Muzoka/Robotic-comp/sim/runs/map1.gif

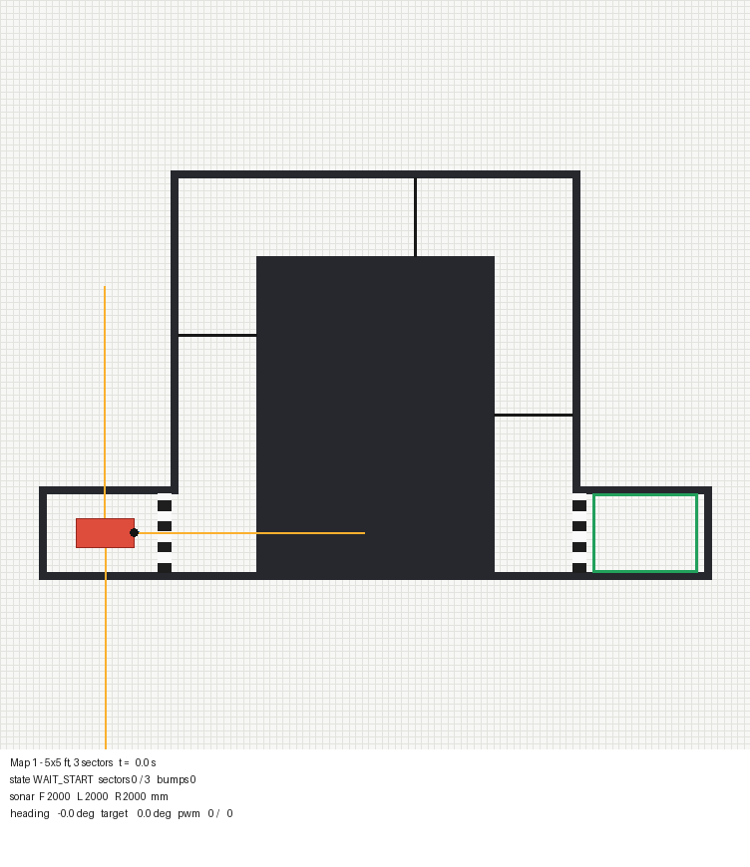
sim/runs/map1.gif
