Muzoka/Robotic-comp/sim/runs/map2.gif

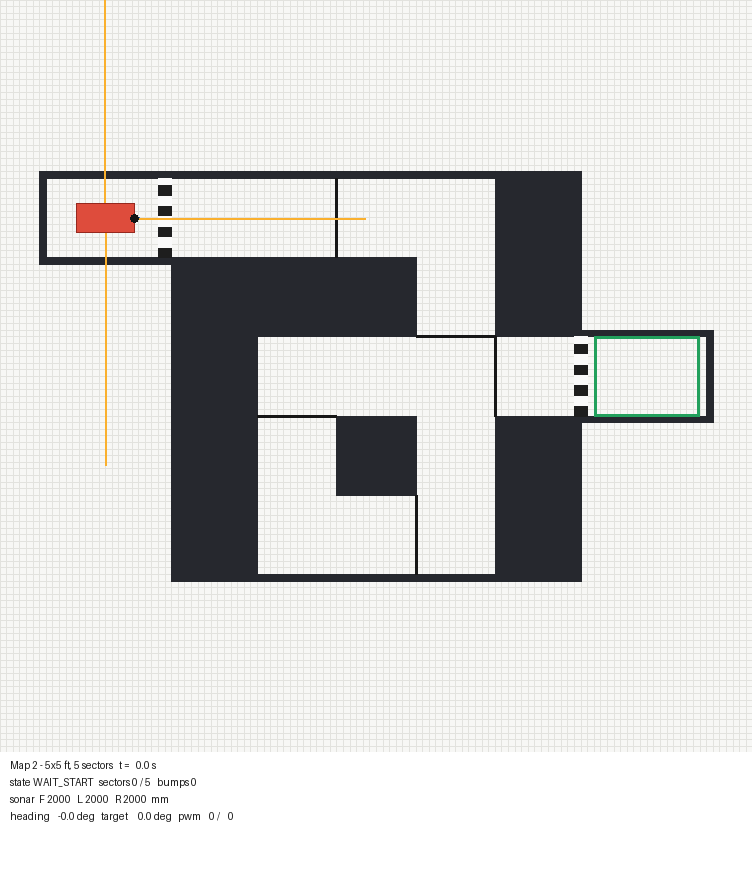
sim/runs/map2.gif
