Muzoka/Robotic-comp/sim/runs/map3.gif

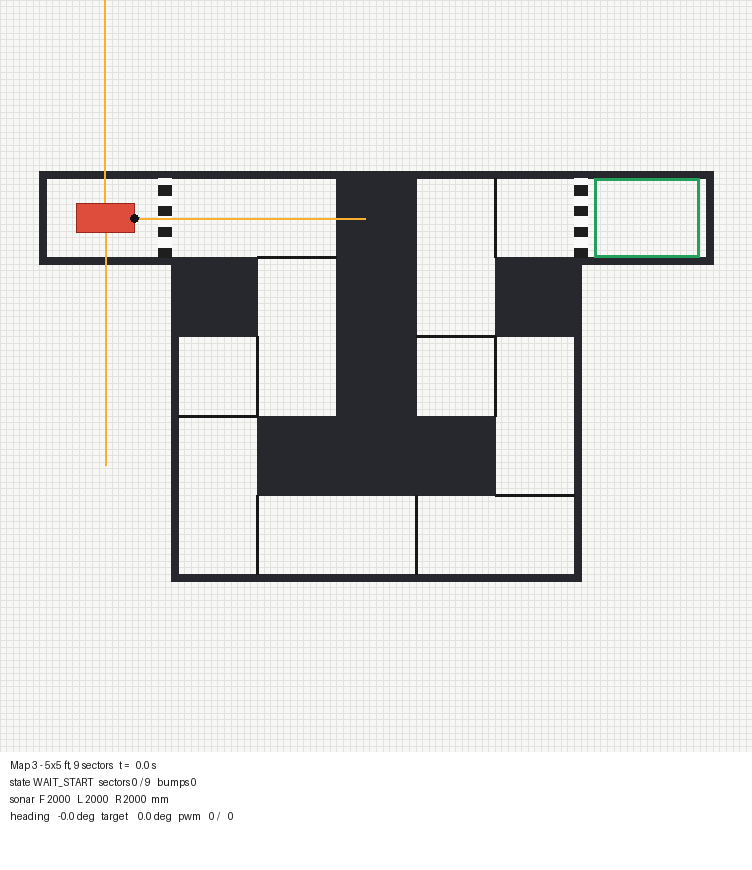
sim/runs/map3.gif
