Muzoka/Robotic-comp/docs/build_guide.html

Language / اللغة EN + ع English عربي

Robotics Navigation Challenge · Arduino Uno

# MazeRunner Build Guide دليل بناء روبوت المتاهة

Everything from the shop counter to the start line: what to buy, how to wire it, what to test at each stage, and what to do on the day. Written for one specific robot that has been simulated to completion — but the method transfers to any two-wheeled maze robot on an Uno.

كل شيء من المحل إلى خط البداية: ماذا تشتري، كيف توصّل الأسلاك، ما الذي تختبره في كل مرحلة، وماذا تفعل يوم المسابقة. مكتوب لروبوت واحد محدد تم اختباره بالمحاكاة حتى نجح في كل الخرائط — لكن الطريقة نفسها تنفع لأي روبوت متاهة بعجلتين يعمل على Arduino Uno.

Maps completed الخرائط المكتملة

3 / 3

Sector points نقاط القطاعات

17 / 17

Simulated runs جولات المحاكاة

96 all passed

Slowest map أبطأ خريطة

48 s of 180

Wall contact الاصطدام بالجدران

0

PHASE 00

## Before you spend anything قبل أن تصرف ريالاً واحداً

~30 minNo parts neededلا تحتاج أي قطعة

One measurement decides whether this robot can work at all, and it is not about code. A two-wheeled robot pivoting on the spot sweeps a circle as wide as its body diagonal. If that circle does not fit between the walls, the robot cannot turn around — no amount of tuning fixes it.

هناك قياس واحد يحدد إن كان هذا الروبوت سينجح أصلاً، ولا علاقة له بالبرمجة. الروبوت ذو العجلتين حين يدور حول نفسه يرسم دائرة قطرها بقدر قطر جسمه (من زاوية إلى الزاوية المقابلة). إذا كانت هذه الدائرة أوسع من المسافة بين الجدارين، فالروبوت لا يستطيع الدوران — ولن يصلحه أي ضبط في الكود.

The competition passage is one foot: 304.8 mm.

عرض الممر في المسابقة قدم واحدة: 304.8 مم.

Robot size مقاس الروبوت | Body diagonal قطر الجسم | Clearance الهامش | Verdict النتيجة
250 × 150 mm | 292 mm | 6 mm | Jams in cornersينحشر في الزوايا
220 × 115 mm | 248 mm | 28 mm | Target — build to thisالهدف — ابنِ على هذا المقاس
200 × 110 mm | 228 mm | 38 mm | Fits, but twitchy — short wheelbaseيمر، لكنه غير مستقر بسبب قصر المسافة بين العجلتين

220 × 115 mm is a measured optimum, not a guess. Narrower is not automatically better: a narrower body means a shorter wheelbase, which makes the robot more sensitive to motor mismatch. In simulation, 110 mm wide completed 83% of runs and 115 mm completed 97%.

مقاس 220 × 115 مم نتيجة قياس، وليس تخميناً. الأضيق ليس أفضل تلقائياً: الجسم الأضيق يعني مسافة أقصر بين العجلتين، وهذا يجعل الروبوت أكثر حساسية لاختلاف قوة المحركين. في المحاكاة، العرض 110 مم أكمل 83% من الجولات، بينما 115 مم أكمل 97%.

Measure this today · قِس هذا اليوم

Put a ruler across your chassis as it stands, nose to tail and tyre-outside to tyre-outside. Most kit builds come out around 250 × 150 mm, and almost all of the excess is in the front ultrasonic bracket hanging off the nose. You need to find about 3 cm of length. Knowing that now changes what you buy.

ضع المسطرة على الهيكل كما هو الآن: من المقدمة إلى المؤخرة، ومن الحافة الخارجية للإطار الأيسر إلى الحافة الخارجية للإطار الأيمن. أغلب الروبوتات المبنية من الكِت تكون حوالي 250 × 150 مم، والزيادة كلها تقريباً في حامل الحساس الأمامي البارز من المقدمة. تحتاج أن تقلّص حوالي 3 سم من الطول. معرفة هذا الآن تغيّر ما ستشتريه.

### Two questions worth asking the organisers سؤالان يستحقان أن تسألهما اللجنة المنظّمة

1. What is the actual passage width? The rulebook says 200–400 mm and calls the dimensions "tentative". At 200 mm no standard kit robot can turn at all — that affects every team equally and is worth raising early, in writing.
2. Are the start and finish gates marked on the floor? It changes nothing in the code, but it is good to know what the robot will see.
1. ما هو عرض الممر الفعلي؟ اللوائح تقول 200–400 مم وتصف الأبعاد بأنها «مبدئية». عند 200 مم لا يستطيع أي روبوت كِت قياسي أن يدور إطلاقاً — وهذا يؤثر على كل الفرق بالتساوي، ويستحق أن تسأل عنه مبكراً وكتابةً.
2. هل خطوط البداية والنهاية مرسومة على الأرض؟ لا يغيّر شيئاً في الكود، لكن من الجيد أن تعرف ما الذي سيراه الروبوت.

PHASE 01

## Shopping المشتريات

Half a day~300 SAR electronics + ~300 SAR tools

Two trips: an electronics shop, then SACO. No practice track — you have the real one, which saves about 120 SAR and a full weekend of cutting foam board.

رحلتان: محل إلكترونيات، ثم ساكو. لا حاجة لمسار تدريب — لديك المسار الحقيقي، وهذا يوفر حوالي 120 ريال وعطلة نهاية أسبوع كاملة من تقطيع الفوم بورد.

### Which to choose when there is a choice أيهما تختار عند وجود خيارين

Scoring is sector points first (§6.1); time only breaks ties (§6.3). So reliability wins the event and weight wins the tie-break. Buy the reliable option, and take the lighter one only where it costs nothing.

التقييم يعتمد أولاً على نقاط القطاعات (المادة 6.1)، والوقت يُستخدم فقط عند التعادل (المادة 6.3). إذن الاعتمادية تكسب البطولة، والخفة تكسب التعادل. اشترِ الخيار الأكثر اعتمادية، وخذ الأخف فقط حين لا يكلّفك شيئاً.

### Electronics shop (الموجات الإلكترونية، شارع الملك فهد، الخبر)

- MPU-6050 / GY-521 gyro × 2 — 15–25 SAR each. The highest-value part you can add: it is what makes a turn actually 90°. Buy two — a dead gyro on the day ends your event. Not a compass module (HMC5883L/QMC5883); the motors fool it. حساس جيروسكوب MPU-6050 عدد 2 — 15–25 ريال للحبة. أهم قطعة يمكن إضافتها: هي التي تجعل اللفة 90 درجة فعلاً. اشترِ اثنين — جيروسكوب تالف يوم المسابقة ينهي مشاركتك. وليس حساس بوصلة (HMC5883L/QMC5883)؛ المحركات تشوّش عليه.
- LM393 slot encoder × 2 (+2 spare) — 8–12 SAR each. The slotted discs in your kit only fit these. حساس دوران العجلة LM393 عدد 2 (+2 احتياطي) — 8–12 ريال للحبة. الأقراص المشقوقة في الكِت لا تناسب غيرها.
- Momentary push button × 2 — 2 SAR each. The GO button. Two wires, no resistor. زر ضغط لحظي عدد 2 — 2 ريال للحبة. زر التشغيل GO. سلكان فقط، بدون مقاومة.
- 2 × 18650 Li-ion + holder + charger — ~60 SAR. 7.4 V, ~95 g, rechargeable, holds voltage under load. This is the reliable choice. بطاريتان 18650 + بيت بطارية + شاحن — حوالي 60 ريال. 7.4 فولت، ~95 غرام، قابلة للشحن، وتحافظ على الفولت تحت الحمل. هذا هو الخيار الموثوق.
- Rocker/toggle switch, 3 A × 2 — 5 SAR each. Master power. One is enough; buy a spare. مفتاح تشغيل 3 أمبير عدد 2 — 5 ريال للحبة. مفتاح الطاقة الرئيسي. واحد يكفي، والثاني احتياطي.
- Inline fuse holder + 3 A fuse — 8 SAR. Insurance against a shorted motor lead. حامل فيوز + فيوز 3 أمبير — 8 ريال. تأمين ضد قصر في سلك المحرك.
- 1000 µF 16 V capacitor × 2 — 3 SAR each. Across the L298N supply; stops motor surges resetting the Arduino. مكثف 1000 مايكروفاراد 16 فولت عدد 2 — 3 ريال للحبة. يوضع على تغذية الـ L298N؛ يمنع اندفاع تيار المحركات من إعادة تشغيل الأردوينو.
- 100 nF ceramic ("104") × 10 — 1 SAR each. One across each motor's terminals; kills the brush noise that upsets the gyro. مكثف سيراميك 104 عدد 10 — 1 ريال للحبة. واحد على طرفَي كل محرك؛ يزيل التشويش الكهربائي الذي يربك الجيروسكوب.
- JST-XH connector kit + crimp tool — ~60 SAR. Cables cut to exact length, sensors unplug for repair. The biggest tidiness win. A Dupont kit is the cheaper substitute. طقم وصلات JST-XH + كماشة تكريب — حوالي 60 ريال. أسلاك مقصوصة بالطول المضبوط، وحساسات تُفصل بسهولة للإصلاح. أكبر مكسب في ترتيب الأسلاك. طقم Dupont بديل أرخص.
- 22 AWG stranded wire, 3 colours — 15 SAR. Stranded, not solid. Solid wire work-hardens and snaps from vibration. سلك 22 مجدول، 3 ألوان — 15 ريال. مجدول وليس مصمت. السلك المصمت يتقصّف وينكسر من الاهتزاز.
- Heat-shrink assortment — 15 SAR. §5.1 forbids exposed conductor. أنابيب حرارية بمقاسات مختلفة — 15 ريال. المادة 5.1 تمنع أي سلك مكشوف.
- Spiral cable wrap 6 mm, 2 m — 10 SAR. لفافة أسلاك حلزونية 6 مم، 2 متر — 10 ريال.
- Pin headers, male + female — 10 SAR. هيدر ذكر وأنثى — 10 ريال.
- Spare HC-SR04 × 2 — 20 SAR each. They die. حساس مسافة HC-SR04 احتياطي عدد 2 — 20 ريال للحبة. تتلف بسهولة.
- Optional: piezo buzzer 5 V — 5 SAR. In parallel with the LED, so the countdown is audible to a judge. اختياري: صافرة 5 فولت — 5 ريال. توصَّل بالتوازي مع الـ LED ليسمع الحكم العد التنازلي.

Do not buy · لا تشترِ

- Any second microcontroller — ESP32, Nano, Pi. Rule §2.2, instant disqualification, even fitted and unused.
- An external memory chip. The Uno's built-in 1 kB EEPROM is ten times what this needs — the junction memory uses 192 bytes.
- A TCRT5000 line sensor. It was in an earlier version of this design and was removed: its only job was spotting the finish, and a TCRT5000 chatters crossing tape at an angle, which could stop the robot mid-map.
- Laser distance sensors (VL53L0X/VL53L1X). Modelled, and they measured worse than HC-SR04 here — a wide sonar cone averages a whole square of wall, which is what a wall-follower wants.
- أي متحكم ثانٍ — ESP32 أو Nano أو Raspberry Pi. المادة 2.2: استبعاد فوري، حتى لو كان مركّباً وغير مستخدم.
- شريحة ذاكرة خارجية. ذاكرة EEPROM المدمجة في الأردوينو (1 كيلوبايت) أكبر بعشر مرات مما نحتاج — ذاكرة التقاطعات تستخدم 192 بايت فقط.
- حساس خط TCRT5000. كان موجوداً في نسخة سابقة من التصميم ثم حُذف: وظيفته الوحيدة كانت اكتشاف خط النهاية، وهذا الحساس يعطي قراءات متذبذبة عند عبور الشريط بزاوية مائلة، مما قد يوقف الروبوت في منتصف الخريطة.
- حساسات المسافة بالليزر (VL53L0X/VL53L1X). جرّبناها في النموذج وكانت النتيجة أسوأ من HC-SR04 هنا — لأن مخروط الموجات الصوتية العريض يعطي متوسطاً لمربع كامل من الجدار، وهذا بالضبط ما يحتاجه متتبّع الجدار.

### SACO (ساكو) — tools الأدوات

- Soldering iron 40–60 W + stand, solder, flux — 90 SAR كاوي لحام 40–60 واط + قاعدة + قصدير + معجون لحام — 90 ريال
- Digital multimeter — 60 SAR. You will use this more than you expect. أفوميتر رقمي — 60 ريال. ستستخدمه أكثر مما تتوقع.
- Precision screwdriver set + PH1/PH2 — 50 SAR طقم مفكات دقيقة + مفك صليبة PH1/PH2 — 50 ريال
- Needle-nose pliers, side cutters, wire strippers — 55 SAR زرادية مدببة، قصافة، مقشّر أسلاك — 55 ريال
- Desoldering braid — 10 SAR شريط شفط اللحام — 10 ريال
- Hot glue gun + sticks — 30 SAR مسدس شمع + أصابع لاصقة — 30 ريال
- Craft knife, small files — 25 SAR كتر ومبارد صغيرة — 25 ريال
- Safety glasses — 15 SAR نظارة أمان — 15 ريال
- Parts organiser box — 25 SAR علبة تنظيم قطع — 25 ريال
- Tape measure + long steel ruler — to measure the real track the first time you see it متر قياس + مسطرة حديد طويلة — لقياس المسار الحقيقي أول مرة تراه

### SACO — fasteners المسامير والتثبيت

- M3 screws 6/8/10/12/20 mm — steel where it carries load مسامير M3 بأطوال 6/8/10/12/20 مم — حديد في الأماكن التي تحمل وزناً
- M3 NYLON standoffs 10–25 mm — buy nylon, not brass. Same job, a third of the weight, and you need 8–12. Free ~25 g. فواصل نايلون M3 بطول 10–25 مم — اشترِ نايلون وليس نحاس. نفس الوظيفة بثلث الوزن، وتحتاج 8–12 حبة. توفير مجاني ~25 غرام.
- M3 nylon screws + nuts — for the sensor boards, which carry nothing. Another ~10 g. مسامير وصواميل نايلون M3 — لتثبيت ألواح الحساسات التي لا تحمل وزناً. توفير ~10 غرام إضافية.
- M3 steel nuts, nylon lock nuts, washers — steel for the motor brackets only صواميل حديد M3، صواميل قفل نايلون، ورد — الحديد لحوامل المحركات فقط
- M2 screws + nuts — sensor modules مسامير وصواميل M2 — لوحدات الحساسات
- Blue thread-lock — vibration loosens everything on this robot مثبّت مسامير أزرق — الاهتزاز يفكّ كل شيء في هذا الروبوت
- Zip ties 100 mm + adhesive mounts ربطات بلاستيك 100 مم + قواعد لاصقة
- Double-sided foam tape (3M VHB if stocked) — for mounting the gyro flat and rigid لاصق وجهين إسفنجي (3M VHB إن توفر) — لتثبيت الجيروسكوب مستوياً وثابتاً
- Electrical tape شريط عازل كهربائي

Free weight — about 90 g · توفير وزن مجاني ~90 غرام

Nylon standoffs instead of brass (~35 g), leaving the breadboard off the robot (~30 g, and §2.2 explicitly allows it), cutting wires to length instead of coiling jumper leads (~15 g), green perfboard instead of the white breadboard (~25 g). On a ~600 g robot that is 15%, and it shows up as quicker starts out of every one of Map 3's eight turns.

فواصل نايلون بدل النحاس (~35 غرام)، وترك البريدبورد خارج الروبوت (~30 غرام، والمادة 2.2 تسمح بذلك صراحةً)، وقص الأسلاك بالطول المضبوط بدل لفّ الزائد منها (~15 غرام)، واستخدام اللوح الأخضر (perfboard) بدل البريدبورد الأبيض (~25 غرام). على روبوت وزنه ~600 غرام هذه نسبة 15%، وتظهر كانطلاقة أسرع بعد كل لفة من لفات الخريطة الثالثة الثماني.

PHASE 02

## Software setup تجهيز البرامج

~45 minLaptop only

#### Install the Arduino IDE ثبّت برنامج Arduino IDE

1. Download from arduino.cc/en/software — take IDE 2.x. Install with the default options and let it install the USB drivers when it asks.
  نزّله من arduino.cc/en/software — اختر IDE 2.x. ثبّته بالخيارات الافتراضية، ووافق على تثبيت تعريفات USB حين يطلب منك ذلك.

#### Install the CH340 driver ثبّت تعريف CH340

2. Kit Unos are usually clones with a CH340 USB chip rather than the original FTDI. If you plug the board in and no port appears, this is why. Search "CH340 driver" for your operating system, install it, and replug.
  لوحات الأردوينو في الكِتات عادة نسخ مقلّدة تستخدم شريحة CH340 بدل FTDI الأصلية. إذا وصّلت اللوحة ولم يظهر أي منفذ (Port)، فهذا هو السبب. ابحث عن «CH340 driver» لنظام تشغيلك، ثبّته، ثم أعد توصيل اللوحة.
  Windows: the port shows up as COM3 or similar. macOS: /dev/cu.wchusbserial.... Linux: /dev/ttyUSB0.
  ويندوز: يظهر المنفذ باسم COM3 أو ما شابه. ماك: /dev/cu.wchusbserial.... لينكس: /dev/ttyUSB0.

#### Select the board اختر اللوحة والمنفذ

3. In the IDE: Tools → Board → Arduino AVR Boards → Arduino Uno, then Tools → Port → whichever port appeared in the previous step.
  من البرنامج: Tools → Board → Arduino AVR Boards → Arduino Uno، ثم Tools → Port → المنفذ الذي ظهر في الخطوة السابقة.

#### Prove the toolchain with Blink تأكد أن كل شيء يعمل بمثال Blink

4. File → Examples → 01.Basics → Blink, then press Upload (the arrow). The board's LED should blink once a second.
  File → Examples → 01.Basics → Blink، ثم اضغط Upload (سهم الرفع). يجب أن يومض ضوء اللوحة مرة كل ثانية.
  Pass · نجح
  Blink uploads and runs. Do not go further until it does — every later problem is easier to diagnose once you know uploading works.
  مثال Blink يُرفع ويعمل. لا تكمل قبل أن ينجح — كل مشكلة لاحقة تصبح أسهل في التشخيص حين تكون متأكداً أن الرفع يعمل.

#### Get the project files احصل على ملفات المشروع

5. terminal

git clone https://github.com/Muzoka/Robotic-comp.git
cd Robotic-comp
  Otherwise use GitHub's Code → Download ZIP and unzip it.
  أو استخدم Code → Download ZIP من GitHub ثم فك الضغط.

#### Run the geometry check — Python only شغّل فحص الأبعاد — بايثون فقط

6. This is the one tool you should not skip, and it is the easiest to set up: no compiler, no libraries, nothing to install but Python. It reads your measurements out of config.h and tells you whether the robot can physically turn around in the corridor.
  هذه الأداة الوحيدة التي لا يجب تخطّيها، وهي أسهل شيء في التجهيز: بدون مترجم، بدون مكتبات، لا تحتاج سوى بايثون. تقرأ قياساتك من ملف config.h وتخبرك إن كان الروبوت قادراً فعلياً على الدوران داخل الممر.
  Install Python from python.org/downloads. On Windows, tick "Add python.exe to PATH" on the first screen of the installer — it is easy to miss and everything fails without it.
  ثبّت بايثون من python.org/downloads. في ويندوز، ضع علامة على خيار "Add python.exe to PATH" في أول شاشة من التثبيت — من السهل نسيانه، وبدونه لن يعمل شيء.
  Windows — PowerShell, in the project folder

python tools\geometry_check.py
  macOS / Linux

python3 tools/geometry_check.py
  On Windows the command is python, not python3, and paths use backslashes. To open a terminal in the right place: open the project folder in File Explorer, click the address bar, type powershell, press Enter.
  في ويندوز الأمر هو python وليس python3، والمسارات تستخدم الشرطة المائلة العكسية. لفتح موجّه الأوامر في المكان الصحيح: افتح مجلد المشروع في مستكشف الملفات، اضغط على شريط العنوان، اكتب powershell، ثم Enter.
  what you should see

  body                    220 mm long  x   115 mm wide
  turning on the spot sweeps a circle 248 mm across

passage    clearance verdict
200           -24 mm IMPOSSIBLE cannot turn round
250             1 mm no        scrapes every corner, will jam
300            26 mm tight     works if it centres itself well  <-- ours
350            51 mm fine      comfortable
  Change ROBOT_LENGTH_MM and ROBOT_WIDTH_MM in firmware/MazeRunner/config.h to your real measurements and run it again. That is the whole loop.
  غيّر ROBOT_LENGTH_MM و ROBOT_WIDTH_MM في ملف firmware/MazeRunner/config.h إلى قياساتك الحقيقية ثم شغّل الأمر مرة أخرى. هذه هي الدورة كاملة.

#### Optional: the full maze simulator اختياري: محاكي المتاهة الكامل

7. This one watches the robot drive all three maps and saves an animated GIF of each. It needs two more things: the pillow image library and a C++ compiler.
  هذا يعرض الروبوت وهو يقود الخرائط الثلاث ويحفظ صورة متحركة GIF لكل خريطة. يحتاج شيئين إضافيين: مكتبة الصور pillow ومترجم ++C.
  The compiler is the awkward part on Windows, and it is there for a good reason — the simulator runs the real firmware. nav_core.cpp is compiled twice: once by the Arduino IDE onto the Uno, once into a library the Python simulator drives.
  المترجم هو الجزء المزعج في ويندوز، ووجوده لسبب وجيه — المحاكي يشغّل الكود الحقيقي نفسه. ملف nav_core.cpp يُترجم مرتين: مرة بواسطة Arduino IDE إلى اللوحة، ومرة إلى مكتبة يشغّلها محاكي بايثون.

#### Windows: install WSL ويندوز: ثبّت WSL

  WSL gives you a real Linux inside Windows. Open PowerShell as Administrator (right-click the Start button → Terminal (Admin)):
  WSL يعطيك نظام لينكس حقيقياً داخل ويندوز. افتح PowerShell كمسؤول (كليك يمين على زر ابدأ ← Terminal (Admin)):
  PowerShell, as Administrator — then reboot

wsl --install
  Reboot, open Ubuntu from the Start menu, and let it set up a username and password. Then, inside Ubuntu:
  أعد تشغيل الجهاز، افتح Ubuntu من قائمة ابدأ، وأنشئ اسم مستخدم وكلمة مرور. ثم داخل Ubuntu:
  Ubuntu terminal

sudo apt update && sudo apt install -y g++ python3-pip
pip3 install pillow

cd /mnt/c/Users/YOURNAME/Downloads/Robotic-comp
cd sim && python3 run.py --all
  Your Windows C: drive appears as /mnt/c inside Ubuntu, so the project does not need to move. The GIFs land in sim/runs/.
  قرص C: في ويندوز يظهر باسم /mnt/c داخل Ubuntu، فلا حاجة لنقل المشروع. الصور المتحركة تُحفظ في sim/runs/.
  If you skip this · إذا تخطيت هذه الخطوة
  Nothing is lost that you cannot get elsewhere. Wokwi (Phase 03) already proves the firmware runs, and the geometry check above already answers the question that decides the build.
  لن تخسر شيئاً لا يمكنك الحصول عليه من مكان آخر. موقع Wokwi (المرحلة 03) يثبت أن الكود يعمل، وفحص الأبعاد أعلاه يجيب على السؤال الذي يحدد نجاح البناء.

PHASE 03

## Test the code before you own the parts اختبر الكود قبل أن تشتري القطع

~1 hourBrowser only · free

Wokwi (https://wokwi.com) is a browser Arduino simulator. It cannot tell you whether the robot navigates a maze — it has no wheels — but it proves the pin map, the I²C gyro, the sonar timing and the whole state machine. This is the cheapest bug-finding available, and it found three real bugs in this project that the maze simulator could not.

موقع Wokwi (https://wokwi.com) محاكي أردوينو يعمل في المتصفح. لا يستطيع إخبارك إن كان الروبوت سيجتاز المتاهة — فليس فيه عجلات — لكنه يثبت صحة توزيع الأطراف (pins)، وعمل الجيروسكوب عبر I²C، وتوقيت حساسات المسافة، وآلة الحالات كاملة. هذه أرخص طريقة لاكتشاف الأخطاء، وقد اكتشفت ثلاثة أخطاء حقيقية في هذا المشروع لم يستطع محاكي المتاهة اكتشافها.

#### New project مشروع جديد

1. Sign in at wokwi.com (free) → New Project → Arduino Uno.
  سجّل الدخول في wokwi.com (مجاني) ← New Project → Arduino Uno.

#### Paste two files الصق ملفين

2. Click the diagram.json tab, select all, delete, paste wokwi/diagram.json. Then the sketch.ino tab, select all, delete, paste wokwi/sketch.ino.
  اضغط على تبويب diagram.json، حدد الكل، احذف، ثم الصق محتوى wokwi/diagram.json. ثم تبويب sketch.ino، حدد الكل، احذف، والصق wokwi/sketch.ino.
  Use wokwi/sketch.ino · استخدم wokwi/sketch.ino تحديداً
  firmware/MazeRunner/MazeRunner.ino is split across four files and opens with #include "config.h". Paste that one on its own and the build stops with fatal error: config.h: No such file or directory.
  ملف firmware/MazeRunner/MazeRunner.ino مقسّم على أربعة ملفات ويبدأ بسطر #include "config.h". إذا لصقته وحده سيتوقف البناء برسالة fatal error: config.h: No such file or directory. أما wokwi/sketch.ino فهو نفس الكود مدموجاً في ملف واحد.

#### Press play, open Serial Monitor at 115200 شغّل، وافتح الشاشة التسلسلية على 115200

3. expected output

# MazeRunner booting - hold still, calibrating gyro
# gyro OK
# ready. Press GO, or wave a hand in front of the nose.
t_ms,state,dF,dL,dR,head,tgt,encL,encR,pwmL,pwmR,sect
2685,WAIT_START,602,2000,2000,0.0,0.0,0,0,0,0,0

  602 is the front sensor's default slider (60 cm) and 90 the sides (9 cm). Seeing the right numbers on the right channels is your pin map confirmed.
  الرقم 602 هو القيمة الافتراضية للحساس الأمامي (60 سم)، و90 للحساسين الجانبيين (9 سم). ظهور الأرقام الصحيحة في الأعمدة الصحيحة يعني أن توزيع الأطراف سليم.

#### Check it does nothing on its own تأكد أنه لا يتحرك من نفسه

4. Leave it alone for ten seconds. It must stay in WAIT_START.
  اتركه عشر ثوانٍ دون أن تلمسه. يجب أن يبقى في حالة WAIT_START.

#### Press the red GO button اضغط زر GO الأحمر

5. expected

# GO pressed
6088,COUNTDOWN,602,90,90,...      <- D13 blinks ~3 s
9088,DRIVE,602,90,90,...,200,200  <- both motors forward
9988,STUCK,602,90,90,...,-140,-55 <- expected, see below

Why STUCK is correct here · لماذا ظهور STUCK صحيح

Wokwi has no wheels, so the encoder counts never rise. From the firmware's point of view the motors are running and the wheels are not turning, which is exactly what "jammed" means — so the watchdog fires after 900 ms. Tap the blue and green buttons to feed it fake encoder ticks, or ignore it.

لا توجد عجلات في Wokwi، لذا لا ترتفع قراءات حساسات الدوران أبداً. من وجهة نظر الكود، المحركات تعمل والعجلات لا تدور — وهذا بالضبط معنى «محشور» — فيعمل نظام الحماية بعد 900 مللي ثانية. اضغط الزرين الأزرق والأخضر لتغذيته بنبضات وهمية، أو تجاهل الأمر.

PHASE 04

## Bench-test each part, one at a time اختبر كل قطعة على حدة قبل التركيب

~2 hoursBefore assembly

Test every subsystem before it is buried inside the robot. Debugging three subsystems at once is how a week disappears. Full sketches are in tools/serial_check.md.

اختبر كل جزء قبل أن يُدفن داخل الروبوت. محاولة تصحيح ثلاثة أجزاء في وقت واحد هي الطريقة الأسرع لضياع أسبوع كامل. الأكواد الكاملة موجودة في ملف tools/serial_check.md.

Wheels off the ground · ارفع العجلات عن الأرض

Put the chassis on a block for anything involving motors. It will drive off the table otherwise.

ضع الهيكل على قاعدة مرتفعة في أي اختبار فيه محركات، وإلا سيسقط عن الطاولة.

# | Test الاختبار | Pass criteria شرط النجاح

1 | Motorsالمحركات | All four motions correct — both forward, both back, spin left, spin right — and the wheels stop dead in the pause. Note the lowest PWM at which each wheel actually turns; that is PWM_MIN, usually 50–70. الحركات الأربع صحيحة — للأمام، للخلف، دوران يسار، دوران يمين — والعجلات تتوقف تماماً في فترة السكون. سجّل أقل قيمة PWM تدور عندها كل عجلة فعلاً؛ هذه هي PWM_MIN، وعادة بين 50 و70.
2 | Encodersحساسات دوران العجلات | Turn each wheel exactly one revolution by hand; the count rises by 20 (or however many slots your disc has — count them). If it jumps 2–3 per slot you have contact bounce: the disc is rubbing or off-centre. لُف كل عجلة دورة كاملة واحدة باليد؛ يجب أن يزيد العداد 20 (أو حسب عدد الشقوق في قرصك — عُدّها). إذا قفز 2–3 لكل شق فهناك ارتداد: القرص يحتك أو غير مركزي.
3 | Ultrasonicsحساسات المسافة | Hold a flat book at 50, 100, 300 and 1000 mm; each sensor within ~10 mm of a ruler. Then hold the book at 45° — it should report no echo. That is real physics, not a fault. ضع كتاباً مسطحاً على بعد 50 و100 و300 و1000 مم؛ يجب أن يكون كل حساس ضمن ~10 مم من قياس المسطرة. ثم أمِل الكتاب بزاوية 45 درجة — يجب ألا يرجع أي صدى. هذه فيزياء طبيعية وليست عطلاً.
4 | Gyroالجيروسكوب | Three checks: (a) still for 60 s, heading drifts under ±2°; (b) turn 90° by hand against a square, reads 90 ± 3°; (c) turn 90° the other way, reads −90. If the sign is backwards set GYRO_Z_SIGN = -1.0f. ثلاثة فحوص: (أ) اتركه ثابتاً 60 ثانية، يجب ألا ينحرف أكثر من ±2 درجة؛ (ب) لُفّه 90 درجة باليد على زاوية قائمة، يجب أن يقرأ 90 ± 3؛ (ج) لُفّه 90 في الاتجاه المعاكس، يجب أن يقرأ −90. إذا كانت الإشارة معكوسة اضبط GYRO_Z_SIGN = -1.0f.
5 | GO buttonزر التشغيل | Steady 1 untouched, 0 while held, back to 1 on release. يقرأ 1 ثابتاً دون لمس، و0 أثناء الضغط، ويعود إلى 1 عند الإفلات.

Try the cross-talk failure deliberately · جرّب مشكلة التداخل عمداً

In the ultrasonic test, remove the delay(60) between sensors and watch the readings go mad. Three sonars firing together hear each other's pings. That is why the firmware fires them one at a time.

في اختبار حساسات المسافة، احذف delay(60) بين الحساسات وشاهد القراءات تضطرب. ثلاثة حساسات تُطلق في وقت واحد يسمع كل منها نبضات الآخر. لهذا يطلقها الكود واحداً تلو الآخر.

PHASE 05

## Mechanical assembly التجميع الميكانيكي

~4 hoursTarget: 220 × 115 mm

#### Mount the motors with the axle centred ثبّت المحركات ومحور العجلات في المنتصف

1. The wheel axle should sit halfway along the body. An axle mounted two-thirds of the way back makes the pivot circle bigger for no benefit. Steel screws and nylock nuts here; this joint carries load. Thread-lock on every one.
  يجب أن يكون محور العجلات في منتصف طول الجسم. المحور المركّب في الثلث الخلفي يكبّر دائرة الدوران بلا فائدة. استخدم مسامير حديد وصواميل قفل هنا؛ هذا المفصل يحمل وزناً. وضع مثبّت مسامير على كل واحد.

#### Fit the encoder discs and sensors ركّب أقراص وحساسات الدوران

2. The LM393 slot sensor straddles the black slotted disc on the inside of each wheel. Get the disc centred in the slot: if it rubs, it brakes the wheel; too far out and it misses counts.
  حساس LM393 يحيط بالقرص الأسود المشقوق داخل كل عجلة. اجعل القرص في منتصف الشق: إذا احتك سيكبح العجلة، وإذا ابتعد كثيراً سيفوّت نبضات.

#### Bring the body down to size صغّر مقاس الجسم

3. This is the step that decides whether the robot works. Everything must sit inside the tyre line and inside the nose — no bracket, sensor, wire loom or battery sticking out past the tyres or off the front.
  هذه هي الخطوة التي تحدد نجاح الروبوت. كل شيء يجب أن يكون داخل خط الإطارات وداخل حدود المقدمة — لا حامل ولا حساس ولا ضفيرة أسلاك ولا بطارية تبرز خارج الإطارات أو أمام المقدمة.
  The front ultrasonic bracket is almost always the problem. Mount the front sensor flush against the nose, not on an arm. Put the battery on top, never behind the axle — anything behind the axle adds to the tail, and the tail is what sweeps the wall.
  حامل الحساس الأمامي هو المشكلة في أغلب الحالات. ثبّت الحساس الأمامي ملاصقاً للمقدمة، وليس على ذراع بارز. وضع البطارية في الأعلى، وليس خلف المحور أبداً — كل ما هو خلف المحور يزيد طول الذيل، والذيل هو الذي يحتك بالجدار عند الدوران.
  Pass · شرط النجاح
  Nose to tail ≤ 220 mm. Tyre outside to tyre outside ≤ 115 mm. Measure it, do not estimate it.
  من المقدمة إلى المؤخرة ≤ 220 مم. ومن حافة الإطار الخارجية إلى الأخرى ≤ 115 مم. قِس ولا تقدّر.

#### Mount the three ultrasonics ثبّت حساسات المسافة الثلاثة

4. Front one dead ahead in the middle of the nose. Left and right facing exactly 90° out, level, and — this matters — on the wheel-axle line, not ahead of it. That way a gap is seen at the instant the axle draws level with it. Measured: moving them back to the axle line was worth about 20 percentage points of completion on Map 3, and it costs nothing but where you drill.
  الأمامي في منتصف المقدمة تماماً. والأيسر والأيمن يواجهان 90 درجة بالضبط إلى الخارج، بمستوى أفقي، والأهم: على خط محور العجلات وليس أمامه. بهذه الطريقة تُرى الفتحة في اللحظة التي يصل فيها المحور إليها. بالقياس: نقلهما إلى خط المحور رفع نسبة إكمال الخريطة الثالثة حوالي 20 نقطة مئوية، ولا يكلّف شيئاً سوى مكان الثقب.

#### Mount the gyro flat, level and rigid ثبّت الجيروسكوب مستوياً وثابتاً

5. As close to the middle of the robot as you can. Double-sided foam tape, then a zip tie over the top. If it can wobble, it will report the wobble as turning. Keep it away from the motors and from the motor wires — and twist those wires together to cancel their magnetic field.
  أقرب ما يمكن إلى منتصف الروبوت. لاصق إسفنجي وجهين، ثم ربطة بلاستيك فوقه. إذا كان يهتز، فسيسجّل الاهتزاز على أنه دوران. أبعده عن المحركات وعن أسلاكها — واجدل أسلاك المحركات معاً لإلغاء مجالها المغناطيسي.

#### Mount the GO button on the back ثبّت زر التشغيل في المؤخرة

6. On a stiff bracket, so pressing it pushes the robot into the start wall rather than sideways off its line.
  على حامل صلب، بحيث يدفع الضغطُ الروبوتَ نحو جدار البداية بدلاً من أن يزيحه جانبياً عن مساره.

#### Solder the perfboard الحم اللوح الأخضر

7. Use the green perfboard, not the white breadboard. A breadboard's spring contacts shake loose, and your robot is a vibrating gearbox bolted to a plastic plate — a run ends the moment one 5 V jumper lifts 0.3 mm. §2.2 names the breadboard as the one part you may remove, which is the rulebook telling you it expects you to solder.
  استخدم اللوح الأخضر (perfboard) وليس البريدبورد الأبيض. ملامسات البريدبورد الزنبركية تتفكك، وروبوتك عبارة عن صندوق تروس مهتز مثبّت على لوح بلاستيك — تنتهي الجولة في اللحظة التي يرتفع فيها سلك 5 فولت بمقدار 0.3 مم. والمادة 2.2 تذكر البريدبورد كالقطعة الوحيدة المسموح بإزالتها، وهذه إشارة من اللوائح أنها تتوقع منك أن تلحم.
  Lay out: one 5 V rail, one GND rail, three 4-pin headers for the ultrasonics, one 4-pin header for the gyro, two 3-pin headers for the encoders, one 2-pin for the GO button.
  التخطيط: خط 5 فولت واحد، خط أرضي واحد، ثلاثة هيدرات 4 أطراف لحساسات المسافة، هيدر 4 أطراف للجيروسكوب، هيدران 3 أطراف لحساسات الدوران، وهيدر طرفين لزر التشغيل.

PHASE 06

## Wiring, in this order التوصيل، بهذا الترتيب

~3 hoursPower off throughout

Every pin is spoken for. Do not improvise — the firmware assumes exactly this.

كل طرف له وظيفة محددة. لا تجتهد — الكود يفترض هذا التوزيع بالضبط.

Pin | Connects to يوصَّل بـ | Note ملاحظة
D0, D1 | — | Leave alone. USB serial.لا تستخدمهما. منفذ USB.
D2 | LEFT encoder OUTحساس دوران العجلة اليسرى | Interrupt 0
D3 | RIGHT encoder OUTحساس دوران العجلة اليمنى | Interrupt 1
D4 | L298N IN1
D5 | L298N ENA | PWM, RIGHT motorالمحرك الأيمن
D6 | L298N ENB | PWM, LEFT motorالمحرك الأيسر
D7 | L298N IN2
D8 | L298N IN3
D9 | HC-SR04 RIGHT TRIGالحساس الأيمن
D10 | HC-SR04 RIGHT ECHO
D11 | L298N IN4
D12 | GO button → GNDزر التشغيل ← الأرضي | Two wires, no resistorسلكان، بدون مقاومة
D13 | Status LED + buzzerضوء الحالة + صافرة | Output onlyخرج فقط
A0 | HC-SR04 FRONT TRIGالحساس الأمامي
A1 | HC-SR04 FRONT ECHO
A2 | HC-SR04 LEFT TRIGالحساس الأيسر
A3 | HC-SR04 LEFT ECHO
A4 | MPU-6050 SDA | Do not reuseلا تستخدمه لشيء آخر
A5 | MPU-6050 SCL | Do not reuseلا تستخدمه لشيء آخر
VIN | Battery +موجب البطارية | Through switch and fuseعبر المفتاح والفيوز
GND | Common groundالأرضي المشترك

#### Ground first, everywhere الأرضي أولاً، في كل مكان

1. Arduino GND, L298N GND, battery −, and every sensor GND all to one rail. If the sonar reads nonsense later, this is the first thing to check.
  أرضي الأردوينو، وأرضي L298N، وسالب البطارية، وأرضي كل حساس — كلها على خط واحد. إذا أعطت حساسات المسافة قراءات غريبة لاحقاً، فهذا أول ما تفحصه.

#### Power التغذية الكهربائية

2. power path

            [ SWITCH ]   [ 3A FUSE ]
BATT+  ────────/ ──────────▭────────┬──── L298N +12V
                                    └──── Arduino VIN

BATT−  ─────────────────────────────┬──── L298N GND
                                    ├──── Arduino GND
                                    └──── sensor GND rail

Arduino 5V ─────────────────────────┬──── HC-SR04 x3  VCC
                                    ├──── MPU-6050    VCC
                                    └──── LM393 x2    VCC
  - Leave the L298N 5V-EN jumper fitted so the driver powers its own logic.
  - Never join the L298N's 5 V output to the Arduino's 5 V pin.
  - Remove the ENA and ENB jumpers on the L298N. Left fitted, PWM does nothing and the robot has exactly one speed: flat out.
  - Never power the motors from USB. It cannot supply the current and you may damage the port.
  - اترك جمبر 5V-EN مركّباً على L298N ليغذي دائرته المنطقية.
  - لا توصّل خرج 5 فولت من L298N بطرف 5 فولت في الأردوينو أبداً.
  - انزع جمبري ENA و ENB من L298N. إذا بقيا مركّبين، لن يعمل الـ PWM وسيكون للروبوت سرعة واحدة فقط: أقصى سرعة.
  - لا تغذِّ المحركات من منفذ USB أبداً. لا يستطيع توفير التيار وقد تتلف المنفذ.

#### Noise suppression — now, not later كبح التشويش — الآن وليس لاحقاً

3. 1000 µF across the battery at the L298N terminals. 100 nF soldered across each motor's own two terminals, at the motor. Skipping these produces symptoms that look exactly like software bugs: random resets, a gyro that drifts only while driving.
  مكثف 1000 مايكروفاراد على أطراف البطارية عند L298N. ومكثف 100 نانوفاراد ملحوم على طرفَي كل محرك، عند المحرك نفسه. تجاهل هذه المكثفات ينتج أعراضاً تبدو تماماً كأخطاء برمجية: إعادة تشغيل عشوائية، وجيروسكوب ينحرف أثناء القيادة فقط.

#### Motors المحركات

L298N | Goes to | Controlled by
OUT1, OUT2 | RIGHT motorالمحرك الأيمن | ENA (D5), IN1 (D4), IN2 (D7)
OUT3, OUT4 | LEFT motorالمحرك الأيسر | ENB (D6), IN3 (D8), IN4 (D11)

4. If a wheel spins the wrong way · إذا دارت عجلة بالعكس
  Do not swap the wires — set MOTOR_L_SIGN or MOTOR_R_SIGN to -1 in config.h. Swapping wires and signs at the same time is how you lose an afternoon.
  لا تبدّل الأسلاك — بل اضبط MOTOR_L_SIGN أو MOTOR_R_SIGN إلى -1 في config.h. تبديل الأسلاك والإشارات معاً هو الطريقة المضمونة لضياع بعد ظهر كامل.

#### Sensors الحساسات

5. Three ultrasonics, gyro on A4/A5, two encoders, GO button. Leave the MPU's AD0 pin unconnected.
  ثلاثة حساسات مسافة، الجيروسكوب على A4/A5، حساسا الدوران، وزر التشغيل. اترك طرف AD0 في الجيروسكوب غير موصّل.

#### Tidy the loom رتّب ضفيرة الأسلاك

6. Cut every wire to length. Spiral wrap the bundle, zip-tie it down, and check nothing can reach a wheel. Heat-shrink every joint — §5.1 forbids exposed conductor and the inspector will look.
  اقطع كل سلك بالطول المضبوط. لُف الحزمة بلفافة حلزونية، وثبّتها بربطات، وتأكد أن لا شيء يصل إلى العجلات. غطِّ كل وصلة بأنبوب حراري — المادة 5.1 تمنع أي موصل مكشوف، والمحكّم سينظر.

PHASE 07

## First power-up أول تشغيل

~30 minWheels still off the ground

#### Before power: continuity check قبل التشغيل: افحص الاستمرارية

1. Multimeter on continuity. Check battery + to battery − is not shorted, and that GND really is common between the Arduino, the L298N and the sensor rail.
  اضبط الأفوميتر على وضع الاستمرارية. تأكد أن موجب البطارية وسالبها غير متلامسين، وأن الأرضي مشترك فعلاً بين الأردوينو و L298N وخط الحساسات.

#### Open the firmware افتح الكود

2. In the Arduino IDE, open firmware/MazeRunner/MazeRunner.ino. The other three files appear automatically as tabs because they sit in the same folder. No libraries to install.
  من Arduino IDE، افتح firmware/MazeRunner/MazeRunner.ino. الملفات الثلاثة الأخرى تظهر تلقائياً كتبويبات لأنها في نفس المجلد. لا حاجة لتثبيت أي مكتبة.

#### Upload, open Serial Monitor at 115200 ارفع الكود وافتح الشاشة التسلسلية

3. expected

# MazeRunner booting - hold still, calibrating gyro
# gyro OK
# ready. Press GO, or wave a hand in front of the nose.
t_ms,state,dF,dL,dR,head,tgt,encL,encR,pwmL,pwmR,sect
1240,WAIT_START,1850,1200,1300,0.0,0.0,0,0,0,0,0

  # gyro NOT FOUND means the MPU is answering on address 0x69 instead of 0x68 — that happens when AD0 is tied high. Leave AD0 unconnected.
  ظهور # gyro NOT FOUND يعني أن الجيروسكوب يستجيب على العنوان 0x69 بدل 0x68 — وهذا يحدث حين يكون طرف AD0 موصولاً بالموجب. اتركه غير موصّل.

#### Leave it alone for ten seconds اتركه عشر ثوانٍ دون لمس

4. It must stay in WAIT_START and it must not move.
  يجب أن يبقى في حالة WAIT_START وألا يتحرك إطلاقاً.
  Why this check exists · لماذا هذا الفحص موجود
  An earlier version of this firmware started its own run about three seconds after power-on, because the sonar filter's history was zero-initialised and the first reading came out as 0 mm — which the start logic read as a hand held up to the nose. The only symptom was the robot driving off while somebody was still placing it.
  نسخة سابقة من هذا الكود كانت تبدأ الجولة من نفسها بعد حوالي ثلاث ثوانٍ من التشغيل، لأن ذاكرة مرشّح حساس المسافة كانت تبدأ بأصفار فتخرج أول قراءة بقيمة 0 مم — وهو ما فسّره الكود على أنه يد مرفوعة أمام المقدمة. والعرض الوحيد كان أن الروبوت ينطلق بينما ما زال أحدهم يضعه على خط البداية.

#### Press GO اضغط زر التشغيل

5. Serial prints # GO pressed, the LED blinks a 3-second countdown, then the wheels spin. Hold a book in front of the nose and it should go CREEP → TURN.
  تظهر رسالة # GO pressed، ويومض الضوء عداً تنازلياً لثلاث ثوانٍ، ثم تدور العجلات. ضع كتاباً أمام المقدمة، ويجب أن ينتقل إلى CREEP ثم TURN.

PHASE 08

## Measure your robot and calibrate قِس روبوتك واضبط الأرقام

~1 hourThe step most teams skip

Every threshold in the firmware is derived from the robot's geometry. Put in real measurements and the rest follows automatically; leave the defaults and you are tuning against someone else's robot.

كل عتبة في الكود مشتقة من أبعاد الروبوت. أدخل قياساتك الحقيقية وسيتبعها الباقي تلقائياً؛ وإذا تركت القيم الافتراضية فأنت تضبط على روبوت شخص آخر.

Value القيمة | Measure ماذا تقيس | Default
ROBOT_LENGTH_MM | Nose to tail, including anything that sticks outمن المقدمة إلى المؤخرة، شاملاً أي شيء بارز | 220.0
ROBOT_WIDTH_MM | Tyre outside to tyre outside — not the chassis plateمن حافة الإطار الخارجية إلى الأخرى — وليس لوح الهيكل | 115.0
WHEEL_DIAM_MM | Wheel diameterقطر العجلة | 65.0
ENC_TICKS_PER_REV | Count the slots in your disc. Do not assume 20.عُدّ الشقوق في قرصك. لا تفترض أنها 20. | 20
PWM_MIN | Lowest PWM at which the wheels actually turnأقل قيمة PWM تدور عندها العجلات فعلاً | 55
CORRIDOR_MM | The real passage width, measured at the venueعرض الممر الحقيقي، مقيساً في الموقع | 305

Then check it still fits · ثم تأكد أنه ما زال يمر

terminal

python3 tools/geometry_check.py

This prints the swept circle for your numbers. Run it before you tune anything else — if the geometry does not fit, no gain value will save it.

يطبع دائرة الدوران بناءً على أرقامك أنت. شغّله قبل ضبط أي شيء آخر — إذا كانت الأبعاد لا تمر، فلن ينقذك أي رقم في الكود.

PHASE 09

## Tuning on the real track الضبط على المسار الحقيقي

Several sessionsChange one number at a time

#### Measure the track before you drive on it قِس المسار قبل أن تقود عليه

1. Passage width, wall height, overall size. If the passage is not 304.8 mm, put the real number in CORRIDOR_MM and re-run geometry_check.py immediately.
  عرض الممر، ارتفاع الجدار، الأبعاد الكلية. إذا لم يكن العرض 304.8 مم، ضع الرقم الحقيقي في CORRIDOR_MM وأعد تشغيل geometry_check.py فوراً.

#### One straight corridor first ممر مستقيم واحد أولاً

2. Does it drive down the middle without weaving or scraping? If it drifts into a wall, the side sensors are not square. If it weaves, reduce KP_WALL slightly.
  هل يسير في المنتصف بدون تمايل أو احتكاك؟ إذا انحرف نحو جدار، فالحساسات الجانبية غير متعامدة. وإذا تمايل، قلّل KP_WALL قليلاً.

#### One corner زاوية واحدة

3. Does it stop, pivot cleanly, and set off square? A turn that finishes short is usually a loose gyro. A turn that hits the wall mid-pivot means the body is too big — back to Phase 05.
  هل يتوقف، ويدور بنظافة، وينطلق مستقيماً؟ اللفة التي تنتهي ناقصة سببها عادة جيروسكوب غير مثبّت جيداً. واللفة التي تصطدم بالجدار أثناء الدوران تعني أن الجسم كبير جداً — ارجع إلى المرحلة 05.

#### Adjust speed last اضبط السرعة في النهاية

4. PWM_CRUISE is the one number that trades time for safety. It ships at 200. Measured across all three maps:
  PWM_CRUISE هو الرقم الوحيد الذي يوازن بين الوقت والأمان. القيمة المعتمدة 200. القياسات على الخرائط الثلاث:

PWM_CRUISE | Total timeالزمن الكلي | Completedنسبة الإكمال | Wall contact, degraded HWالاصطدام مع عتاد سيئ
110 | 182 s | 100% | —
140 | 147 s | 100% | —
170 | 128 s | 100% | 100
200 | 116 s | 100% | none
230 | 108 s | 100% | none

  200 rather than 230 for a reason you can see in the code: steering is added to cruise and then clamped at 255, so at 200 the robot can still swing 135 counts of left–right difference to save a bad corner; at 230 only 105. If the real track is slipperier than the model, drop to 170.
  اخترنا 200 بدل 230 لسبب تراه في الكود: قيمة التوجيه تُضاف إلى سرعة السير ثم تُقصّ عند 255، فعند 200 يستطيع الروبوت أن يحدث فرقاً بين العجلتين قدره 135 وحدة لإنقاذ زاوية سيئة؛ أما عند 230 فـ 105 فقط. إذا كان المسار الحقيقي أكثر انزلاقاً من النموذج، انزل إلى 170.

Discipline · انضباط

Change one number, run it three times, write down what happened. Changing three things at once and getting a better lap teaches you nothing.

غيّر رقماً واحداً، جرّب ثلاث مرات، ودوّن ما حدث. تغيير ثلاثة أشياء دفعة واحدة والحصول على جولة أفضل لا يعلّمك شيئاً.

PHASE 10

## Competition day يوم المسابقة

Print this phaseاطبع هذه المرحلة

### The bag الحقيبة

- Robot, assembled and workingالروبوت مجمّعاً ويعمل
- Laptop + USB cable + chargerلابتوب + كيبل USB + الشاحن
- Three charged battery sets + chargerثلاث مجموعات بطاريات مشحونة + الشاحن
- Spares: MPU-6050, HC-SR04 ×2, LM393, push button, jumper leadsقطع احتياطية: جيروسكوب، حساسا مسافة، حساس دوران، زر ضغط، أسلاك توصيل
- Soldering iron, solder, cutters, screwdrivers, multimeterكاوي لحام، قصدير، قصافة، مفكات، أفوميتر
- M3 screws, nuts, nylon standoffs, zip tiesمسامير M3، صواميل، فواصل نايلون، ربطات
- Black tape, marker, tape measureشريط أسود، قلم تحديد، متر قياس
- The kit box with every original part, including the breadboardعلبة الكِت بكل القطع الأصلية، ومنها البريدبورد — للفحص الفني
- This guide, printedهذا الدليل مطبوعاً

### Technical inspection (§11) الفحص الفني (المادة 11)

They check ما يفحصونه | You show / say ما تقوله أو تعرضه
Kit completenessاكتمال الكِت | Here is the box with every original partهذه العلبة وفيها كل القطع الأصلية
No replacementsلا استبدال | Original Uno, original L298N, original motors, original chassisأردوينو أصلي، L298N أصلي، محركات أصلية، هيكل أصلي
Breadboardالبريدبورد | §2.2 permits removing it. Here it is in the box — we soldered instead, for reliabilityالمادة 2.2 تسمح بإزالته. ها هو في العلبة — لحمنا بدلاً منه لزيادة الاعتمادية
Add-onsالإضافات | Three ultrasonics (§2.2 allows three), one gyro, two encoders, one button. All sensors — no second microcontrollerثلاثة حساسات مسافة (المادة 2.2 تسمح بثلاثة)، جيروسكوب، حساسا دوران، زر واحد. كلها حساسات — ولا يوجد متحكم ثانٍ
Batteryالبطارية | 7.4 V — under the 12 V per-supply and 20 V total limits7.4 فولت — أقل من حد 12 فولت للمصدر و20 فولت للمجموع
Safetyالسلامة | No exposed conductor, no sharp edges, everything bolted, master switch hereلا موصلات مكشوفة، لا حواف حادة، كل شيء مثبّت بالمسامير، والمفتاح الرئيسي هنا
Autonomyالاستقلالية | No radio of any kind. It starts on its own — watchلا يوجد أي اتصال لاسلكي. ينطلق ذاتياً — تفضلوا شاهدوا

### Starting a run بدء الجولة

the whole procedure

1.  Switch on. It calibrates the gyro - KEEP IT STILL for ~3 s.
2.  Place it in the Start Zone, pointing down the first corridor.
3.  Watch it for ten seconds without touching it. It must NOT move.
4.  Press the GO button on the back. Step back.
5.  The LED blinks a 3-second countdown.
6.  It goes. Do not touch it again (3.4).
1. شغّل المفتاح. يعاير الجيروسكوب — أبقه ثابتاً تماماً لثلاث ثوانٍ.
2. ضعه في منطقة البداية، موجهاً نحو الممر الأول.
3. راقبه عشر ثوانٍ دون أن تلمسه. يجب ألا يتحرك.
4. اضغط زر GO في المؤخرة، ثم ابتعد.
5. يومض الضوء عداً تنازلياً لثلاث ثوانٍ.
6. ينطلق. لا تلمسه بعد ذلك (المادة 3.4).

Backup start, if the button fails: hold a hand about 5 cm in front of the nose for a second, then take it away. Same countdown, same run.

طريقة بديلة للبدء إذا تعطل الزر: ضع يدك على بعد 5 سم أمام المقدمة لثانية واحدة ثم ارفعها. نفس العد التنازلي ونفس الجولة.

### Strategy الاستراتيجية

- Points, not speed. One point per sector line all three wheels fully cross (§6.1); time only breaks ties (§6.3).
- Finishing is not required to score. A robot that keeps moving and keeps crossing lines beats one that solves two maps and jams on the third.
- Attempts: §3.3 gives 2–3 attempts only if you did not complete the map. Completing slowly beats failing quickly.
- Do not touch the robot during a run (§3.4, §6.2). If it is stuck, let the judge stop it.
- النقاط وليس السرعة. نقطة واحدة لكل خط قطاع تعبره العجلات الثلاث كاملةً (المادة 6.1)؛ والوقت يُستخدم فقط عند التعادل (المادة 6.3).
- إكمال الخريطة ليس شرطاً للتسجيل. الروبوت الذي يستمر في الحركة ويعبر الخطوط يتفوق على من يحل خريطتين ثم ينحشر في الثالثة.
- المحاولات: المادة 3.3 تمنح 2–3 محاولات فقط إذا لم تُكمل الخريطة. الإكمال ببطء أفضل من الفشل بسرعة.
- لا تلمس الروبوت أثناء الجولة (المادتان 3.4 و6.2). إذا انحشر، اترك الحكم يوقفه.

PHASE 11

## When it goes wrong حين تحدث مشكلة

Fixes you can do at the table

Symptom العَرَض | Cause السبب | Fix الحل
Curves into a wall on a straightينحرف نحو الجدار في الخط المستقيم | Gyro not calibrated — it moved during bootالجيروسكوب غير معاير — تحرك أثناء التشغيل | Power cycle, keep it stillأعد التشغيل وأبقه ثابتاً
Turns short or longاللفة ناقصة أو زائدة | Gyro loose, or upside downالجيروسكوب غير مثبّت أو مقلوب | Tighten it; check GYRO_Z_SIGNثبّته جيداً وافحص GYRO_Z_SIGN
Stops dead, motors hummingيتوقف والمحركات تطنّ | Battery flat, or wedgedالبطارية فارغة أو الروبوت محشور | New batteryبطارية جديدة
Spins in placeيدور في مكانه | Both side sensors reading "open"الحساسان الجانبيان يقرآن «مفتوح» | Check 5 V and GND on the side sonarsافحص 5 فولت والأرضي على الحساسين الجانبيين
Ignores a turnيتجاوز اللفة | Side sensor mounted too far back or crookedالحساس الجانبي مركّب متأخراً أو مائلاً | Re-square the sensorأعد ضبط الحساس ليكون متعامداً
Resets mid-runيعيد التشغيل أثناء الجولة | Motor surge browning out the Arduinoاندفاع تيار المحركات يسبب هبوط الجهد | Check the 1000 µF capacitor is fittedتأكد من تركيب مكثف 1000 مايكروفاراد
Sonar reads nonsenseقراءات المسافة غير منطقية | Grounds not commonالأرضي غير مشترك | One GND rail for everythingخط أرضي واحد للجميع
Only one speed, flat outسرعة واحدة فقط، أقصى سرعة | ENA/ENB jumpers still on the L298Nجمبرا ENA/ENB ما زالا مركّبين | Remove themانزعهما

Between runs, do not edit code · لا تعدّل الكود بين الجولات

Nothing in that table needs a code change. Do not edit code between runs unless you have a genuine, understood reason — and if you do, run it in the simulator first, even at the venue.

لا شيء في هذا الجدول يحتاج تعديل كود. لا تعدّل الكود بين الجولات إلا لسبب حقيقي تفهمه تماماً — وإذا فعلت، جرّبه في المحاكي أولاً، حتى لو كنت في الصالة.

PHASE 12

## For other students using this للطلاب الآخرين الذين سيستخدمون المشروع

What transfers, what does not

The repository is at github.com/Muzoka/Robotic-comp. Everything in it is reusable. Three things are worth understanding before you adapt it.

المستودع على github.com/Muzoka/Robotic-comp. كل ما فيه قابل لإعادة الاستخدام. ثلاثة أمور تستحق أن تفهمها قبل أن تعدّله.

### The simulator runs the real firmware المحاكي يشغّل الكود الحقيقي نفسه

nav_core.cpp contains all the navigation and no Arduino code at all. It is compiled twice: by the Arduino IDE onto the Uno, and by g++ into a shared library that a Python simulator drives. So a behaviour you see in simulation is the behaviour of the code you flash — not a model of it. If you build anything like this, copy that idea before you copy any tuning value.

ملف nav_core.cpp يحتوي كل منطق الملاحة ولا يحتوي أي كود خاص بالأردوينو. يُترجم مرتين: بواسطة Arduino IDE إلى اللوحة، وبواسطة g++ إلى مكتبة يشغّلها محاكي بايثون. لذلك أي سلوك تراه في المحاكاة هو سلوك الكود الذي سترفعه فعلاً — وليس نموذجاً عنه. إذا بنيت شيئاً مشابهاً، انسخ هذه الفكرة قبل أن تنسخ أي رقم ضبط.

### Your maze is not this maze متاهتك ليست هذه المتاهة

The three maps live in sim/maps/build_maps.py as 5×5 grids of P (passage) and X (wall). Change them to yours, re-run the script, and the simulator, the sector lines and the route all follow. It also checks whether your maze has a dead end — if it does, set DEFAULT_MODE to MODE_TREMAUX.

الخرائط الثلاث موجودة في sim/maps/build_maps.py على شكل شبكات 5×5 من P (ممر) وX (جدار). غيّرها إلى خرائطك، وأعد تشغيل السكربت، وسيتبعها المحاكي وخطوط القطاعات والمسار كلها. كما يفحص إن كانت متاهتك فيها طريق مسدود — إن وُجد، اضبط DEFAULT_MODE على MODE_TREMAUX.

### The one rule that mattered most القاعدة الأهم في المشروع كله

At a junction, go straight if the way ahead is open; only ask the wall-following rule when it is not. One line. On the map with a 4-way crossing it removed both pivots in the crossing — the worst place to turn, because with no wall on either side there is nothing to square up against afterwards. It also lifted the speed ceiling from 170 to 200 and made the left-hand and right-hand rules produce identical routes.

عند التقاطع، امضِ مستقيماً إذا كان الطريق أمامك مفتوحاً، ولا تسأل قاعدة تتبّع الجدار إلا إذا كان مغلقاً. سطر واحد. في الخريطة التي فيها تقاطع رباعي، حذفت هذه القاعدة كلتا اللفتين داخل التقاطع — وهو أسوأ مكان للدوران، لأنه بلا جدار على أي من الجانبين لا يوجد ما يستقيم عليه الروبوت بعد اللفة. كما رفعت سقف السرعة من 170 إلى 200، وجعلت قاعدتَي اليد اليمنى واليسرى تنتجان نفس المسار.

### Things that measured worse than expected أشياء كانت نتيجتها أسوأ من المتوقع

Written down because they are the standard advice and they lost here, on a robot with 20-tick encoders in a 1-foot corridor: trapezoidal turn profiles (78% → 72% completion), yaw-rate damping (78% → 55%), PWM slew limiting (78% → 67%), and laser rangefinders instead of ultrasonics. All are still in the code, switched off, with the measurements beside them. Measure on your own robot before adopting any of it — including this guide.

دوّنّاها لأنها النصيحة الشائعة، ومع ذلك خسرت هنا، على روبوت بحساسات دوران ذات 20 شقاً داخل ممر عرضه قدم واحدة: منحنيات الدوران شبه المنحرفة (الإكمال من 78% إلى 72%)، وتخميد معدل الدوران (من 78% إلى 55%)، وتحديد معدل تغيّر PWM (من 78% إلى 67%)، وحساسات الليزر بدل الموجات فوق الصوتية. كلها ما زالت في الكود، معطّلة، ومعها أرقام القياس. قِس على روبوتك أنت قبل أن تأخذ بأي منها — بما في ذلك هذا الدليل نفسه.

the four commands worth knowing

make check     # geometry: can it turn in the corridor?
make test      # start-up safety: it must never start itself
make wokwi     # rebuild the single-file sketch and prove it compiles
make all       # drive all three maps, make GIFs

Built for the Robotics Navigation Challenge, Khobar. Firmware, simulator and documentation: github.com/Muzoka/Robotic-comp. Free to use and adapt — if it helps your team, that is what it is for.

أُعدّ لمسابقة الملاحة الروبوتية، الخبر. الكود والمحاكي والتوثيق على github.com/Muzoka/Robotic-comp. حر الاستخدام والتعديل — إن أفاد فريقك فهذا هو الغرض منه.

0 of 0 checked · مكتمل Clear all
