Muzoka/Robotic-comp/(commit log)

2026-08-16 Add maze-navigation robot project: firmware, simulator, docs
    The simulator runs the actual firmware. nav_core.cpp is compiled twice:
    once by the Arduino IDE onto the Uno, once by g++ into a shared library
    that the Python simulator drives. Tested behaviour is shipped behaviour.
    firmware/ Arduino sketch (hardware only) + shared navigation core:
    wall-centring PD, junction alignment, gyro-closed-loop turns,
    Tremaux junction memory in the Uno's built-in EEPROM, and a
    jam-recovery watchdog.
    sim/ 2D simulator with ray-cast ultrasonics (including the specular
    dropout that loses walls met at a slant), mismatched motors,
    gyro bias drift an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
    [MazeRunner.ino, geometry_check.py, nav_core.h]
2026-08-16 Rebuild maps to measured dimensions; add Wokwi project, wiring drawing, checklists
    Maps are now drawn to the tape-measure numbers from the marked-up photos:
    30 cm passages everywhere, 3 cm grid, sector lines 30 cm straight across,
    start and finish outside the maze, 3-minute run limit in the firmware.
    Map 2 (150x150, island 120x88 flush left) matches its photo and is solved
    8/8 sector points in 38 s. Maps 1 and 3 are best guesses at the internal
    wall layout and are documented as such in docs/10_MAP_NOTES.md.
    Robot geometry updated to the measured 250 x 150 mm. That sweeps a 292 mm
    circle when pivoting, inside a 300 mm passage - 4 mm each side. A size
    sweep across all three maps shows shrinki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
2026-08-16 Rebuild maps from the organisers' spreadsheet; tune the corner approach
    The maps now come from Robotics_Competition_Maps_v2_5x5_grid.xlsx rather
    than from photographs: a 5x5 grid of 1 ft squares, blue = floor, white =
    block, so the passage is exactly 304.8 mm. Walls 19 mm thick, 190 mm tall,
    3 minute limit. Sector counts are the sheet's own: 3, 5 and 9.
    Adds the combined course - the three sections butted together left to
    right, two of them mirrored so every exit meets the next entrance on the
    same row. 4.67 x 1.57 m, 36 ft route, 17 sector points. Rearranging it is
    one line at the top of build_maps.py.
    Three firmware fixes came out of driving the real geometry:
    - A pivot could never sett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
2026-08-16 All three maps now complete inside the 3 minute limit
    Run separately, as three courses - the combined course is no longer
    generated. At 220 x 140 mm the robot completes Map 1 in 65 s, Map 2 in
    42 s and Map 3 in 92 s, 100% of runs over five seeds each.
    Five firmware bugs, all surfaced by driving the real 1 ft grid:
    - The side "there is a gap" threshold was 420 mm. In a 1 ft grid with the
    sonar 68 mm off centre, a wall reads 84 mm and a one-square opening
    reads 389 mm, so the threshold was larger than any opening and the robot
    drove past every turn it should have taken. Now 200 mm, derived from the
    maze rather than guessed.
    - Pivots could not settle: the motor deadband forced 55 PWM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
2026-08-16 Add the eight-seed size sweep; 220 x 140 mm is the measured optimum
    Not merely small enough - the best of the sizes tested. Smaller is worse
    again, because the side sonars end up closer to the centreline than
    TARGET_SIDE_MM assumes and the robot parks slightly off-centre.
    Claude-Session: https://claude.ai/code/session_01JN8LDw1uQBrSYrEBP8ba71
2026-08-16 Derive geometry constants; tune body size; 94% completion on all three maps
    At 220 x 115 mm, twelve seeds per map: Map 1 92% in 64 s, Map 2 100% in
    31 s with zero wall contact, Map 3 92% in 87 s. All well inside the 3
    minute limit.
    config.h no longer carries hand-tuned thresholds that silently stop
    matching the hardware when the body changes. Set ROBOT_LENGTH_MM and
    ROBOT_WIDTH_MM and the wheelbase, axle position, sensor positions,
    wall-following target, opening threshold and turn feed-forward all follow.
    cfg.py resolves the same expressions, so the simulator and the firmware
    still read one source of truth.
    Body size swept properly. Width dominates, and 115 mm is a sharp optimum
    rather tha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
2026-08-16 All three maps complete 100% of runs, full road coverage, no wall contact
    120 runs at 220 x 115 mm: Map 1 35 s, Map 2 45 s, Map 3 53 s, every one
    covering the whole road. Repeated with deliberately degraded hardware -
    double the slip, quadruple the sensor noise, triple the sonar dropout, 15%
    battery sag, up to 15% motor mismatch - still 100% of 75 runs.
    Two fixes took Map 3 from 80% and Map 2 from 87% to 100%:
    - The FRONT sonar reading was used raw at the decision point. Ultrasound
    drops pings constantly, and a single dropped ping read as "the way ahead
    is clear", sending the robot into the wall it was standing in front of
    and from there into a U-turn off the route. It is now debounc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
    [MazeRunner.ino]
2026-08-16 Drive Map 2 the way you drew it: straight through the crossing
    Go straight whenever the way ahead is open, and consult the hand rule only
    when it is not (STRAIGHT_FIRST in config.h). On Map 2 that reproduces the
    hand-drawn route exactly, square for square: east along the top, straight
    down through the 4-way crossing to the bottom row, round the lower loop,
    back east through the crossing and out.
    Why it is worth more than a tidier picture:
    - It never pivots in the open crossing. That square has no wall on either
    side, so a pivot finishing a few degrees short has nothing to correct
    against. Every livelock this project had started there. Map 2 goes from
    6 pivots to 4.
    - The speed ceilin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
    [MazeRunner.ino]
2026-08-16 Add a single-file Wokwi sketch so one paste builds
    Pasting MazeRunner.ino into Wokwi on its own fails with
    sketch.ino:15:10: fatal error: config.h: No such file or directory
    because the firmware is deliberately split across four files and the .ino
    opens by including two of them. The fix was to create three more correctly
    named tabs, which is three chances to get it wrong and a build error that
    reads like a code bug rather than a setup mistake.
    tools/make_wokwi_sketch.py concatenates config.h, nav_core.h, nav_core.cpp
    and MazeRunner.ino in dependency order, hoists the system includes and drops
    the local ones, and writes wokwi/sketch.ino. Generated, never hand-edited,
    so it cannot drift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
    [make_wokwi_sketch.py]
2026-08-16 Fix the Wokwi build: forward-declare the types Arduino prototypes need
    wokwi/sketch.ino failed to build with
    error: 'Junction' does not name a type; did you mean 'union'?
    error: 'Sonar' was not declared in this scope
    The cause is something g++ never does. The Arduino IDE scans a .ino,
    generates a prototype for every function, and inserts them all immediately
    before the first function definition - which sits ABOVE the lines where
    Junction, Nav and Sonar are defined. Prototypes mentioning those types then
    fail to compile, pointing at code that is perfectly correct.
    Fix, in two parts:
    - The types are now named structs rather than anonymous
    "typedef struct {...} X;", because an ano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
    [make_wokwi_sketch.py, nav_core.h]
2026-08-16 Stop the robot starting its own run on power-up
    Your Wokwi telemetry caught a bug the simulator could not:
    2685,WAIT_START,0,2000,2000,... front sonar reads 0 mm
    2785,COUNTDOWN,602,90,0,... run begins, nobody touching it
    The median-of-3 filter in sonarPing() kept its history in a zero-initialised
    static array, so the first ping reported median(602, 0, 0) = 0 - a wall
    against the nose. ST_WAIT_START read that as a hand held up to arm the
    start, and two pings later, when the history filled and the reading jumped
    to its real value, read that as the hand being withdrawn. The robot started
    its own run about three seconds after switch-on.
    On the day that is a lost run: it dr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
    [MazeRunner.ino, test_start.py]
2026-08-16 Give the GO button its own pin: D13 sharing never worked
    The button did nothing in Wokwi. It shared D13 with the status LED, which
    meant the firmware had to flip the pin between OUTPUT and INPUT_PULLUP a
    hundred times a second to sample it, with a 330 ohm resistor in series so a
    press could not short the LED drive into ground. Presses never registered.
    The sharing only existed because the floor sensor owned D12. That sensor is
    gone, so the button takes D12 and the whole arrangement disappears:
    D12 ──[ GO button ]──── GND
    Internal pull-up, no resistor, no pinMode juggling, nothing to wire
    backwards. D13 goes back to being an output that drives the LED, which is
    all it was e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
    [MazeRunner.ino]
2026-08-16 Add the build guide: one document from shop counter to start line
    Everything needed to build this robot, in the order you do it, so there is
    one thing to follow instead of twelve reference docs. Thirteen phases, each
    with what to do, what it should look like when it works, and what to check
    before moving on: geometry, shopping, software, browser testing, bench
    tests, mechanical assembly, wiring, first power-up, calibration, track
    tuning, competition day, troubleshooting, and a section for other students
    who want to reuse it.
    Written to be shared. The last phase covers what transfers to a different
    maze and what does not - including the techniques that measured WORSE here
    than the standard a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
2026-08-17 Make the build guide bilingual, English and Arabic
    The guide is meant to be handed to students in Khobar and shared with other
    teams, and half of them will read Arabic faster than English. Every
    paragraph, list, callout, table note and checklist item now exists in both.
    A switch at the top picks EN + AR, English only, or Arabic only, and the
    choice is remembered. Arabic-only is a real reading mode, not a courtesy
    translation underneath the English - somebody can follow the whole build in
    Arabic and never see a word of English except the parts that should stay in
    English anyway: pin names, code, config values, serial output. That is how
    the terms appear on the board and in the IDE, so transl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
